ZedLong220/JXS6000/firmware/user-firmware-keil-57/IMAGE/63749d4665ed6ca9.webp

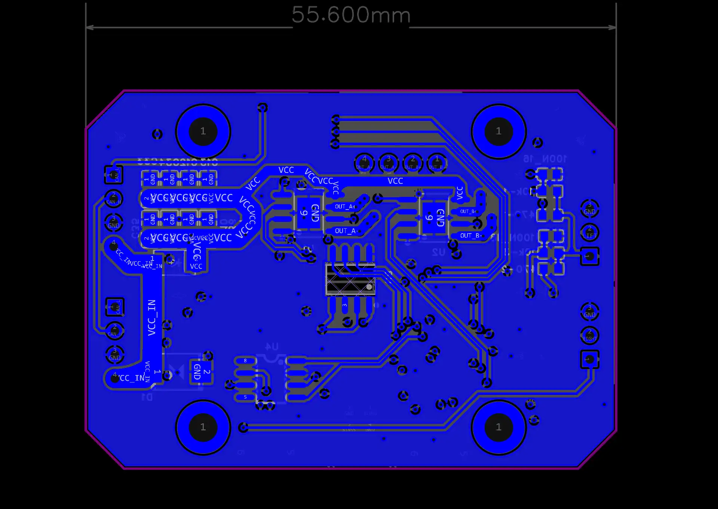
firmware/user-firmware-keil-57/IMAGE/63749d4665ed6ca9.webp
