ZedLong220/JXS6000/firmware/user-firmware-keil-57/IMAGE/d7293e0b1b592a4c.webp

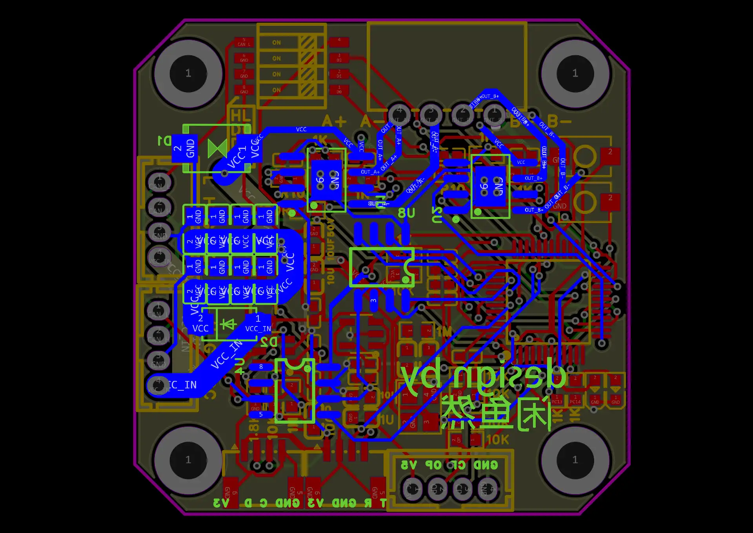
firmware/user-firmware-keil-57/IMAGE/d7293e0b1b592a4c.webp
