ZedLong220/JXS6000/hardware/driver-board/README.md

# 驱动板硬件

`ProPrj_Jyker机械臂手搓FOC 版本_copy_2026-11-09.epro2` 为用户指定的完整硬件工程，按原文件复制，未修改设计内容。

使用支持 `.epro2` 工程归档的嘉立创EDA专业版导入。配套固件位于仓库的 `firmware/user-firmware-keil-57`，已编译HEX位于 `firmware/hex`。文件校验值见仓库根目录 `MANIFEST.sha256`。
