ZedLong220/JXS6000/HMIcode/SmallProject-6000/连续路径更新说明.md

# JXS6000 六轴联动与PA0夹爪 v4

更新日期：2026-11-09。配套SmallProject-6000、jixiebi-V6000和user-firmware-keil-57。J1～J6分别使用CAN节点1～6，六块相同无刹车42步进板可刷同一个本次驱动HEX。改拨码后重启，保持每板独立校准。J6已解除固定，范围-180°～180°，夹爪为独立PWM舵机。

## 上位机操作

- 修改需要运动的J轴角度（自动勾选），确认参与轴后点击“运动勾选轴”；支持1～6轴任意组合，目标0°有效，未勾选轴保持当前位置。
- 勾选需要记录的J轴，点击“记录勾选轴”，只等待对应编码器的新数据；未记录轴显示“—”。记录至少两个点位后点击“勾选轴点位连续运动”，按表格顺序只执行勾选轴，每条点位必须含有所选轴的实测位置。支持仅连接一个或多个驱动板调试。
- “循环（回起点）”会添加本次启动位置再重复，每圈回起点停车。停止按钮可取消检查、上传和运动。
- “圆滑 / mm”默认20、可设1～50：增大可减少拐点减速，但允许绕过记录点；设1偏向精度。重复相邻点自动省略，不生成静止等待段；轨迹限制电机加速度变化率以减轻冲击，当前系统设置默认500圈/秒³。实际反向和循环起终点仍需减速。
- J6网页滑块、键盘和逆解均已启用，保留限位、碰撞和穿地检查。
- 旧记录中的J6=0作为真实的0°目标执行，不再当虚拟轴忽略。

默认减速比J1～J6按2026-11-14实机确认为50/100/100/30/30/1，2026-11-13按现有接线将六轴方向由+/-/+/-/+/+统一反向为-/+/-/+/-/-；方向由上位机MotorCoordinateMap集中定义，目标与编码器反馈使用同一换算。六轴共用每段时间。上位机系统设置默认关节速度60°/s、电机限速15圈/s、加速度23圈/s²、加速度变化率500圈/s³，仍受各板EEPROM限制。参数可调，速度设置下一次运动生效，减速比变更需重启。

## 夹爪舵机

PA0/TIM2_CH1硬件PWM，50Hz，500～2500µs对应0°～180°，沿用指定HAL例程。上电无脉冲，不自动转到90°。夹爪区可拖动目标角度后点击发送，也可发送0°/180°、关闭PWM或查询状态；拖动滑块本身不发送指令。

舵机使用额定电源并与主控共地，PA0接信号线。显示为主控接受的目标角度/脉宽，无舵机位置反馈。机械臂停止保留夹爪PWM；关闭输出需显式操作，不自动松爪。

命令均为节点0：55/DLC4角度float，56/DLC0关闭，57/DLC0查询。返回57/DLC8：角度float、脉宽uint16、启用标志、版本1；每帧仍有3B确认。非法角度、NaN/Inf和长度错误拒绝执行。

## 连续路径与协议

协议升为4，mask=3F表示全部六轴，固定J2/J3为06。主机50开始、51起点、52时间/序号、53各轴目标和出口速度、54提交、3A执行；主控核对六板协议4、会话及段数后广播FF6604+mask启动。旧版本不会混入六轴启动。

六轴本地20kHz共同时间执行，普通拐角按界面设置的几何容差圆滑通过，默认20mm；首末和精确反向停车。该数值是规划几何界，参考关节线性插补映射到TCP，不是笛卡尔直线或实机跟踪误差保证。圆滑后最多32段。

38状态：state,error,onlineMask,movingMask,count,index,axisMask,04。bit0～5=J1～J6，全部在线通常3F。任一参与轴故障、掉线或最终不到位均停止全部六轴。结束须所有板及编码器确认，不能只以目标下发当作完成。

原J2/J3固定点(0,0)→(40,-40)→(10,-50)→(60,-10)→(50,-100)→(0,0)保持不变，并已按2026-11-14反向后的模型通过碰撞检查。J2模型限位为-180°～250°，J3为-330°～180°。未增加独立夹爪网格，J6沿现有URDF法兰轴线。

## 构建与验证

本机发布程序为publish/win-x64-self-contained/SmallProject.exe，复制时保留整个发布目录。源码可使用README中的dotnet publish和npm构建命令。

2087项运动学/规划/编码检查、20项Viewer测试、2939项主控/夹爪检查通过。六轴实际HMI帧→主控源码→六个驱动执行器模拟33424项检查通过，共同结束tick=82380，并覆盖循环、节点6掉线、驱动故障及最终编码器偏差。舵机验证0/90/180到500/1500/2500µs、关闭及非法值拒绝。发布版WPF/WebView2自检25项通过，两份Keil固件0错误0警告。

尚未连接硬件验证实际PWM波形、六轴负载和夹爪行程。
