ZedLong220/JXS6000/firmware/user-firmware-keil-57/IMAGE/58c83566f7e73977.webp

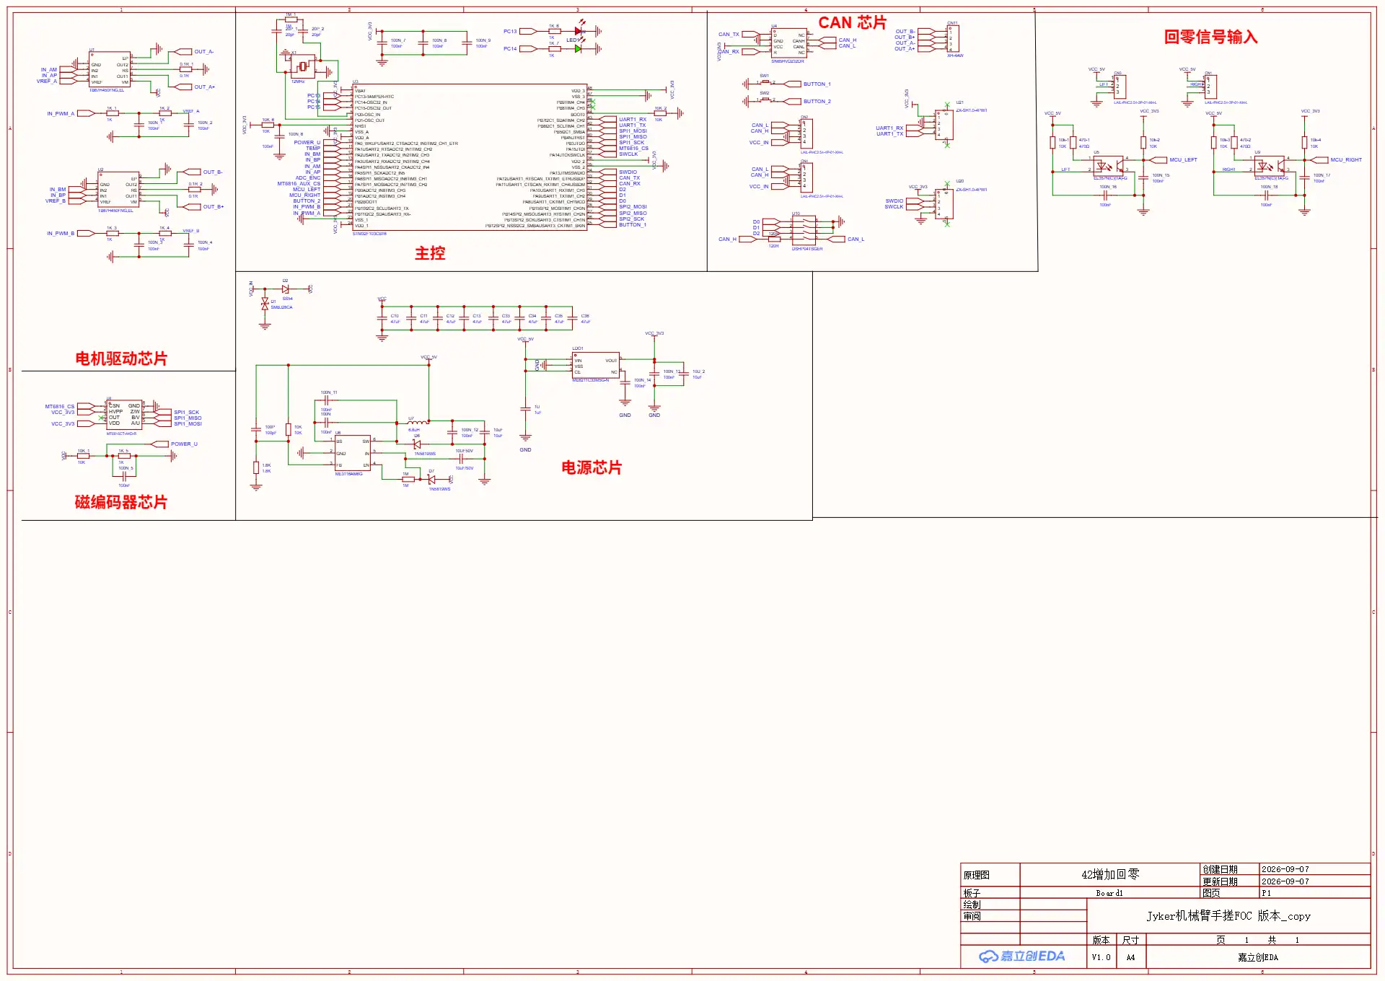
firmware/user-firmware-keil-57/IMAGE/58c83566f7e73977.webp
