ZedLong220/JXS6000/firmware/user-firmware-keil-57/IMAGE/343ae70e3c0fa032.webp

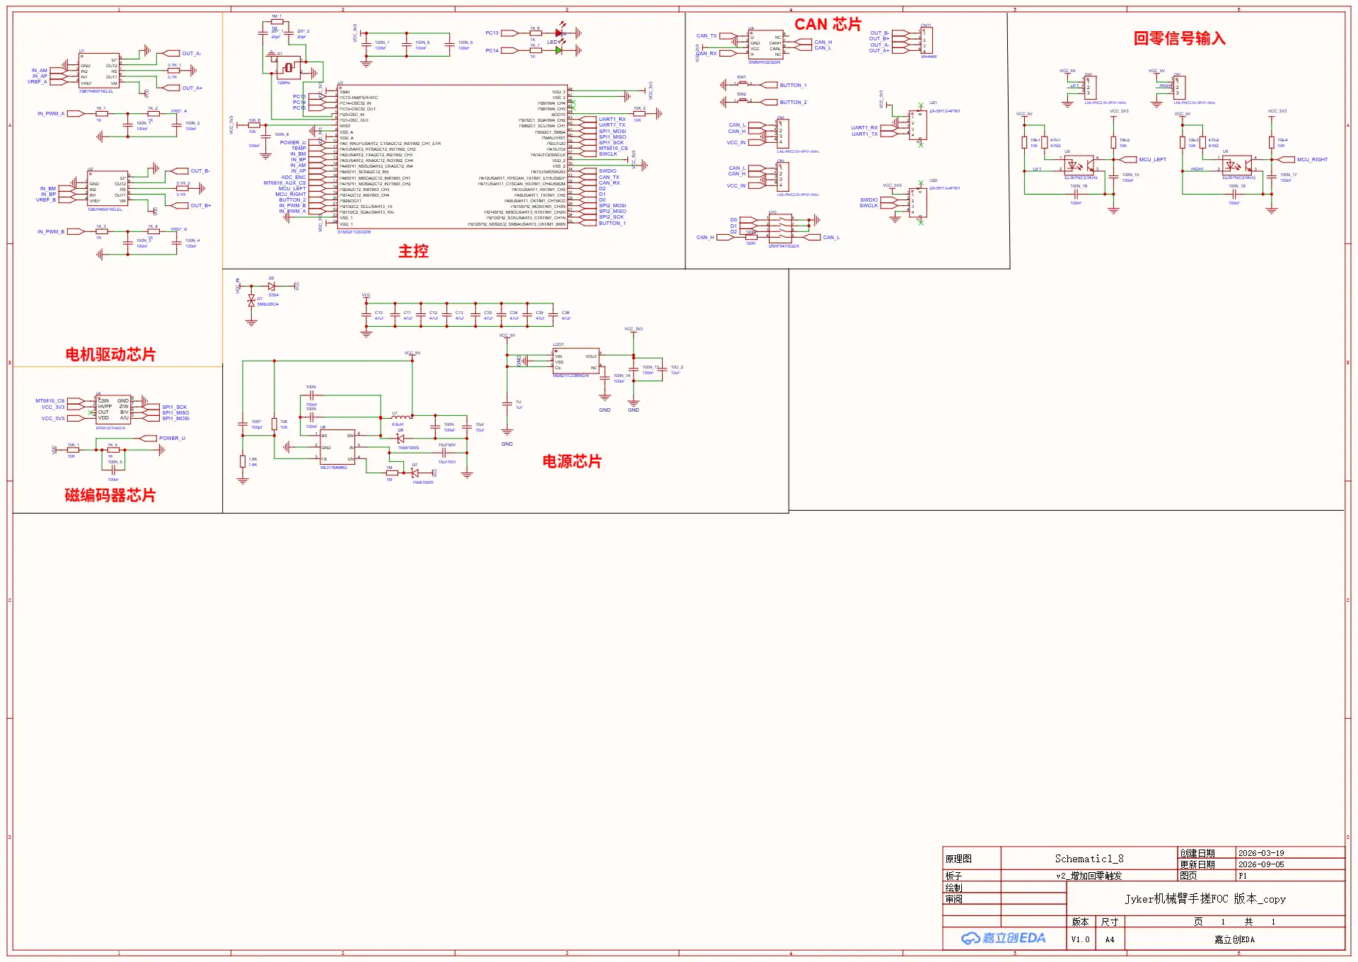
firmware/user-firmware-keil-57/IMAGE/343ae70e3c0fa032.webp
