ZedLong220/JXS6000/firmware/user-firmware-keil-57/IMAGE/ddc2d3c98c696678.webp

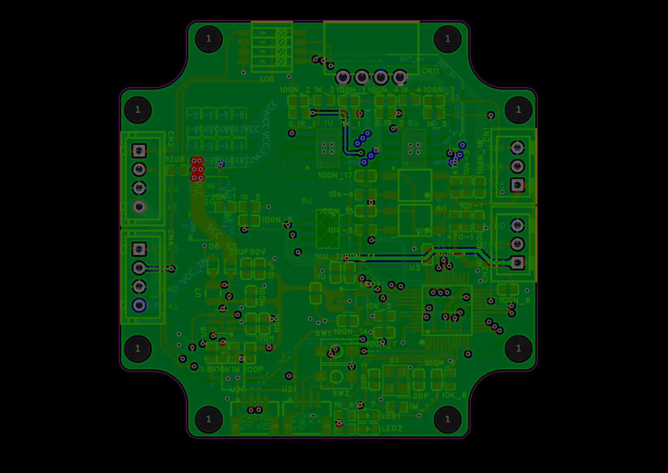
firmware/user-firmware-keil-57/IMAGE/ddc2d3c98c696678.webp
