ZedLong220/JXS6000/HMIcode/SmallProject-6000/SmallProject/Viewer/URDF/jxs6000_description/collision/s1.stl

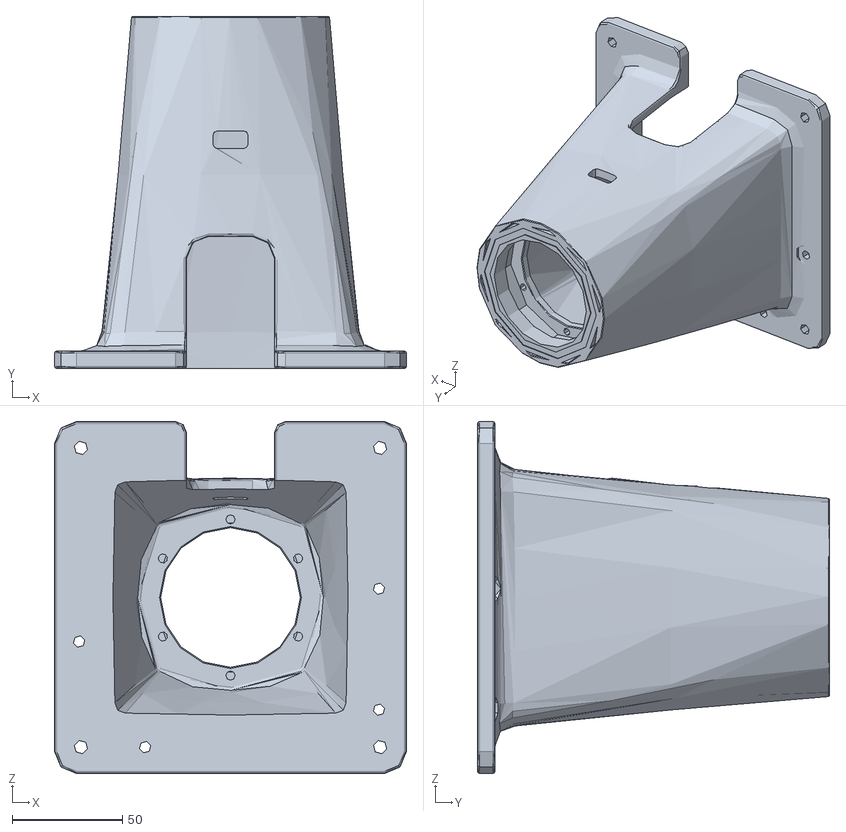
[picture p7: CAD file, 2026-11-09]
HMIcode/SmallProject-6000/SmallProject/Viewer/URDF/jxs6000_description/collision/s1.stl
160.0 x 160.0 x 160.0
