ZedLong220/JXS6000/HMIcode/SmallProject-6000/SmallProject/Viewer/URDF/jxs6000_description/meshes/s5.stl

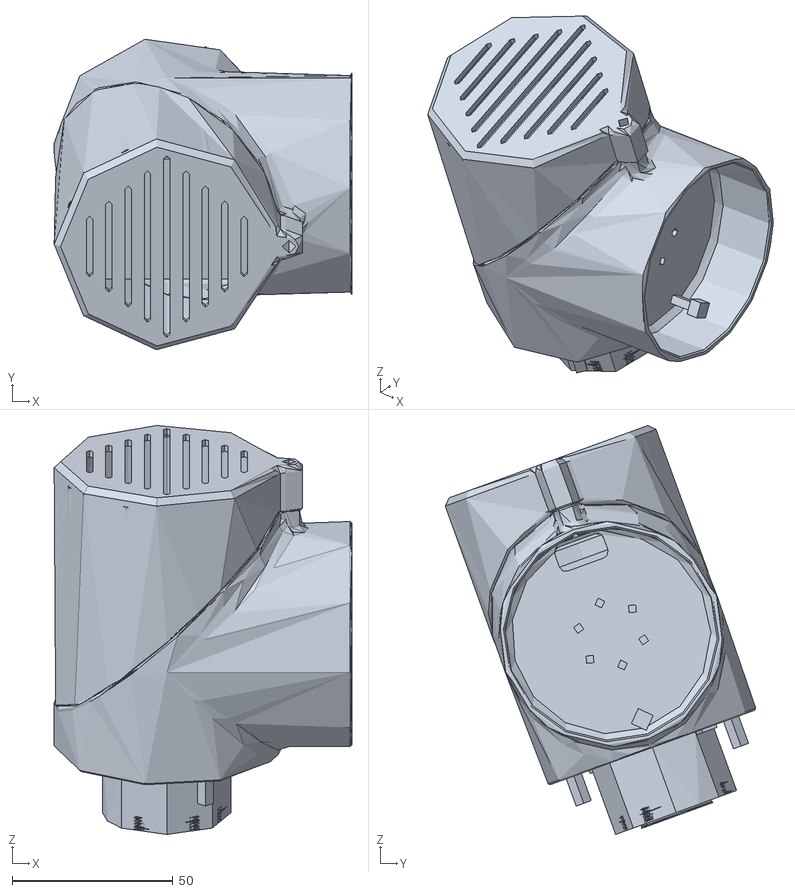
[picture p8: CAD file, 2026-11-09]
HMIcode/SmallProject-6000/SmallProject/Viewer/URDF/jxs6000_description/meshes/s5.stl
92.5 x 96.5 x 127.1
