ZedLong220/JXS6000/HMIcode/SmallProject-6000/ViewerSource/public/URDF/jxs6000_description/collision/s3.stl

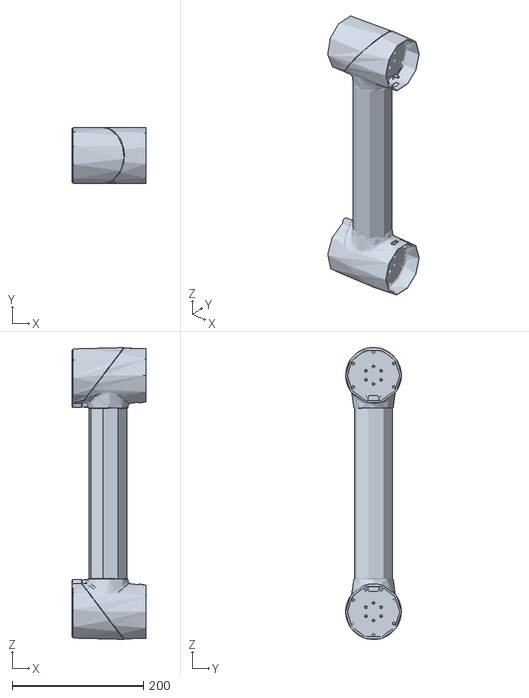
[picture p9: CAD file, 2026-11-09]
HMIcode/SmallProject-6000/ViewerSource/public/URDF/jxs6000_description/collision/s3.stl
113.0 x 85.0 x 444.6
