ZedLong220/JXS6000/HMIcode/SmallProject-6000/SmallProject/Viewer/URDF/jxs6000_description/meshes/s4.stl

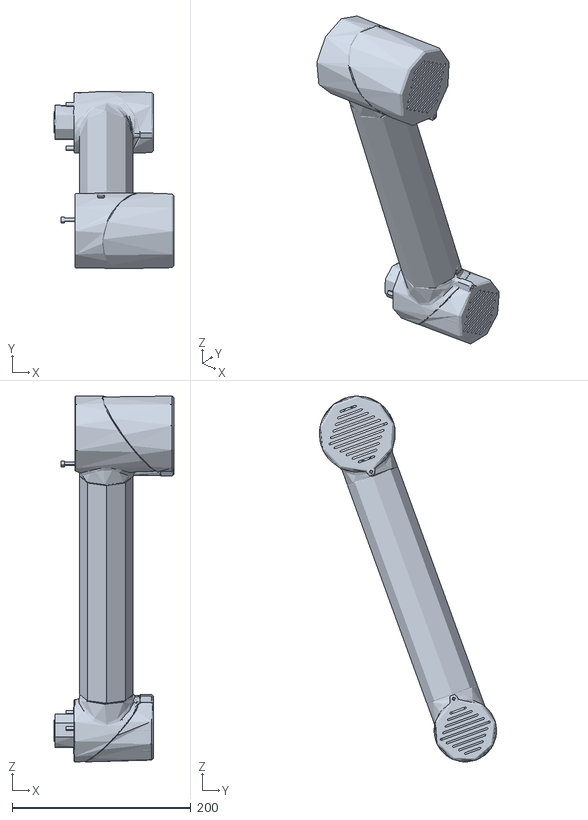
[picture p10: CAD file, 2026-11-09]
HMIcode/SmallProject-6000/SmallProject/Viewer/URDF/jxs6000_description/meshes/s4.stl
134.0 x 198.2 x 409.2
