ZedLong220/JXS6000/HMIcode/SmallProject-6000/ViewerSource/public/URDF/jxs6000_description/meshes/s6.stl

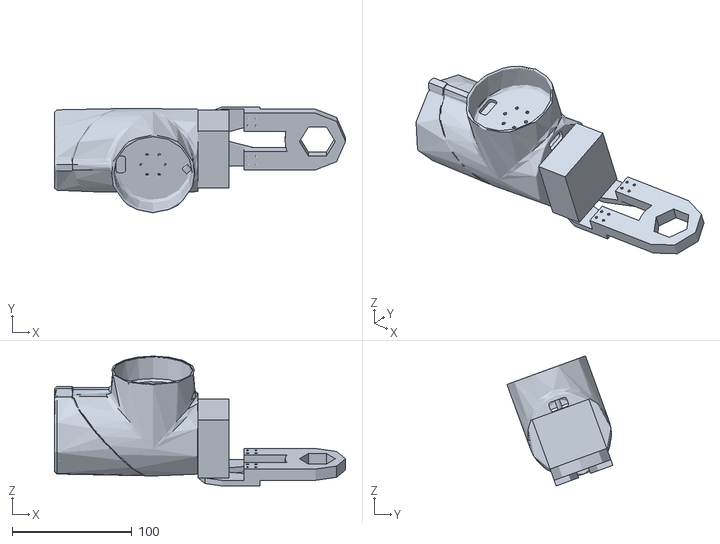
[picture p11: CAD file, 2026-11-09]
HMIcode/SmallProject-6000/ViewerSource/public/URDF/jxs6000_description/meshes/s6.stl
243.5 x 88.6 x 108.7
