ZedLong220/JXS6000/HMIcode/SmallProject-6000/SmallProject/Viewer/URDF/jxs6000_description/collision/s2.stl

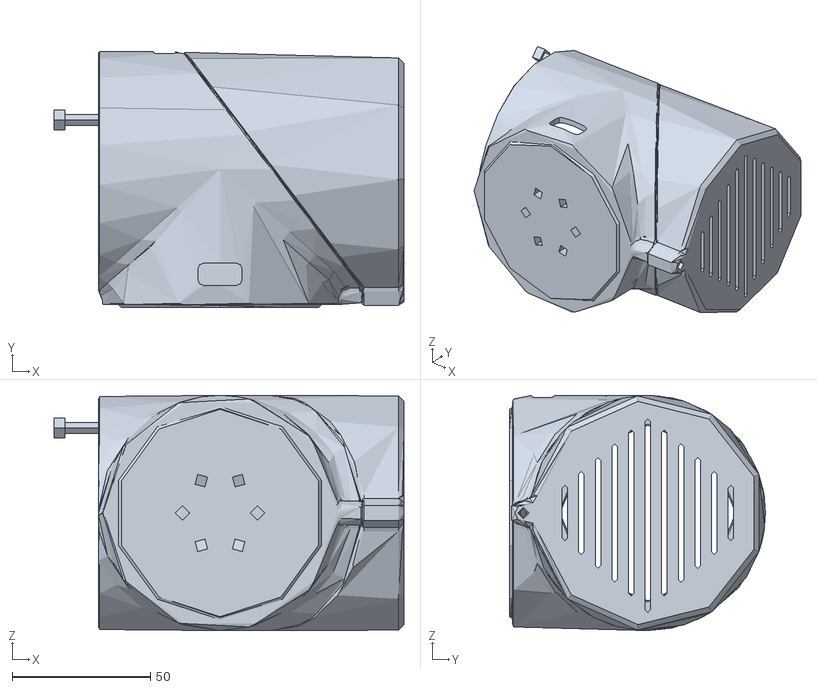
[picture p12: CAD file, 2026-11-09]
HMIcode/SmallProject-6000/SmallProject/Viewer/URDF/jxs6000_description/collision/s2.stl
126.5 x 92.5 x 85.0
