ZedLong220/JXS6000/firmware/jixiebi-V6000/MDK-ARM/build_log.txt

*** Using Compiler 'V5.06 update 4 (build 422)', folder: 'D:\keil\ARM\ARMCC\Bin'
Build target 'jixiebi'
compiling arm_controller.c...
linking...
Program Size: Code=20802 RO-data=942 RW-data=752 ZI-data=4632  
FromELF: creating hex file...
"jixiebi\jixiebi.axf" - 0 Error(s), 0 Warning(s).
Build Time Elapsed:  00:00:02
