ZedLong220/JXS6000/firmware/jixiebi-V6000/Core/Src/tim.c

/**
  ******************************************************************************
  * @file    tim.c
  * @brief   This file provides code for the configuration
  *          of the TIM instances.
  ******************************************************************************
  * @attention
  *
  * <h2><center>&copy; Copyright (c) 2026 STMicroelectronics.
  * All rights reserved.</center></h2>
  *
  * This software component is licensed by ST under BSD 3-Clause license,
  * the "License"; You may not use this file except in compliance with the
  * License. You may obtain a copy of the License at:
  *                        opensource.org/licenses/BSD-3-Clause
  *
  ******************************************************************************
  */

/* Includes ------------------------------------------------------------------*/
#include "tim.h"
#include "gripper_servo.h"

TIM_HandleTypeDef htim2;

/* TIM2 init function */
void MX_TIM2_Init(void)
{

  TIM_ClockConfigTypeDef sClockSourceConfig = {0};
  TIM_MasterConfigTypeDef sMasterConfig = {0};
  TIM_OC_InitTypeDef pwm = {0};

  htim2.Instance = TIM2;
  htim2.Init.Prescaler = 83;
  htim2.Init.CounterMode = TIM_COUNTERMODE_UP;
  htim2.Init.Period = 19999; /* 84 MHz / 84 / 20000 = 50 Hz */
  htim2.Init.ClockDivision = TIM_CLOCKDIVISION_DIV1;
  htim2.Init.AutoReloadPreload = TIM_AUTORELOAD_PRELOAD_DISABLE;
  if (HAL_TIM_Base_Init(&htim2) != HAL_OK)
  {
    Error_Handler();
  }
  sClockSourceConfig.ClockSource = TIM_CLOCKSOURCE_INTERNAL;
  if (HAL_TIM_ConfigClockSource(&htim2, &sClockSourceConfig) != HAL_OK)
  {
    Error_Handler();
  }
  if (HAL_TIM_PWM_Init(&htim2) != HAL_OK) Error_Handler();
  pwm.OCMode = TIM_OCMODE_PWM1;
  pwm.Pulse = 0U; /* No servo pulses until an explicit angle command. */
  pwm.OCPolarity = TIM_OCPOLARITY_HIGH;
  pwm.OCFastMode = TIM_OCFAST_DISABLE;
  if (HAL_TIM_PWM_ConfigChannel(&htim2,&pwm,TIM_CHANNEL_1) != HAL_OK) Error_Handler();
  sMasterConfig.MasterOutputTrigger = TIM_TRGO_RESET;
  sMasterConfig.MasterSlaveMode = TIM_MASTERSLAVEMODE_DISABLE;
  if (HAL_TIMEx_MasterConfigSynchronization(&htim2, &sMasterConfig) != HAL_OK)
  {
    Error_Handler();
  }
}

void HAL_TIM_Base_MspInit(TIM_HandleTypeDef* tim_baseHandle)
{

  if(tim_baseHandle->Instance==TIM2)
  {
    /* TIM2 clock enable */
    __HAL_RCC_TIM2_CLK_ENABLE();

    /* TIM2 interrupt Init */
    /* Hardware PWM needs no timer interrupt; HAL ticks still use SysTick. */
  }
}

void HAL_TIM_Base_MspDeInit(TIM_HandleTypeDef* tim_baseHandle)
{

  if(tim_baseHandle->Instance==TIM2)
  {
    /* Peripheral clock disable */
    __HAL_RCC_TIM2_CLK_DISABLE();

    /* TIM2 interrupt Deinit */
    HAL_NVIC_DisableIRQ(TIM2_IRQn);
  }
}

/* USER CODE BEGIN 1 */
static uint8_t servoPwmRunning;

void GripperHardware_Init(void)
{
    GPIO_InitTypeDef pin = {0};
    MX_TIM2_Init();
    __HAL_RCC_GPIOA_CLK_ENABLE();
    pin.Pin=GPIO_PIN_0;
    pin.Mode=GPIO_MODE_AF_PP;
    pin.Pull=GPIO_PULLDOWN;
    pin.Speed=GPIO_SPEED_FREQ_LOW;
    pin.Alternate=GPIO_AF1_TIM2;
    HAL_GPIO_Init(GPIOA,&pin);
    servoPwmRunning=0U;
}

int GripperHardware_WritePulse(uint16_t microseconds)
{
    __HAL_TIM_SET_COMPARE(&htim2,TIM_CHANNEL_1,microseconds);
    if (!servoPwmRunning) {
        if (HAL_TIM_PWM_Start(&htim2,TIM_CHANNEL_1)!=HAL_OK) return -1;
        servoPwmRunning=1U;
    }
    return 0;
}

/* USER CODE END 1 */

/************************ (C) COPYRIGHT STMicroelectronics *****END OF FILE****/
