ZedLong220/JXS6000/firmware/user-firmware-keil-57/UserApp/common_inc.h

#ifndef LOOP_H
#define LOOP_H

#ifdef __cplusplus
extern "C" {
#endif
/*---------------------------- C Scope ---------------------------*/
#include "stdint.h"

void Main();
void OnUartCmd(uint8_t* _data, uint16_t _len);
void OnCanCmd(uint8_t _cmd, uint8_t* _data, uint32_t _len);
void SendOne();
void SendLimitReached(uint8_t _side, uint8_t _fromCommand);
void SendLimitStatus(void);

#ifdef __cplusplus
}
/*---------------------------- C++ Scope ---------------------------*/
#include <cstdio>
#include "Motor/motor.h"
#include "mt6816_stm32.h"
#include "tb67h450_stm32.h"
#include "encoder_calibrator_stm32.h"
#include "button_stm32.h"
#include "led_stm32.h"
#include "adc.h"
#endif
#endif
