ZedLong220/JXS6000/(commit log)

2026-11-09 Add JXS6000 five-axis HMI, controller, driver firmware and hardware
    [configurations.h, jxs6000.urdf, s1.stl, s2.stl, s3.stl, s4.stl, s5.stl, s6.stl]
2026-11-09 Enable six-axis CAN motion and PA0 gripper servo PWM
    [jxs6000.urdf]
2026-11-09 Move scrollable log panel beside torque monitoring
2026-11-13 Add selected single-axis moves with per-node encoder feedback
2026-11-13 Reverse all six motor coordinate directions for the installed harness
2026-11-14 Align model axes and mirrored joint limits
    [jxs6000.urdf]
