ZedLong220/JXS6000/(notices)

Notices in the files:
firmware/user-firmware-keil-57/Core/Inc/main.h:
© Copyright (c) 2021 STMicroelectronics.
All rights reserved.
